matrixant/f1c200s_core/README.md

#f1c200s_core

> 已打板点灯验证，没有测试过稳定性，谨慎应用。

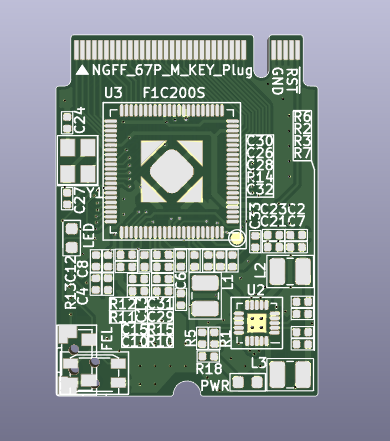
[picture p1: PCB1.png]
PCB1

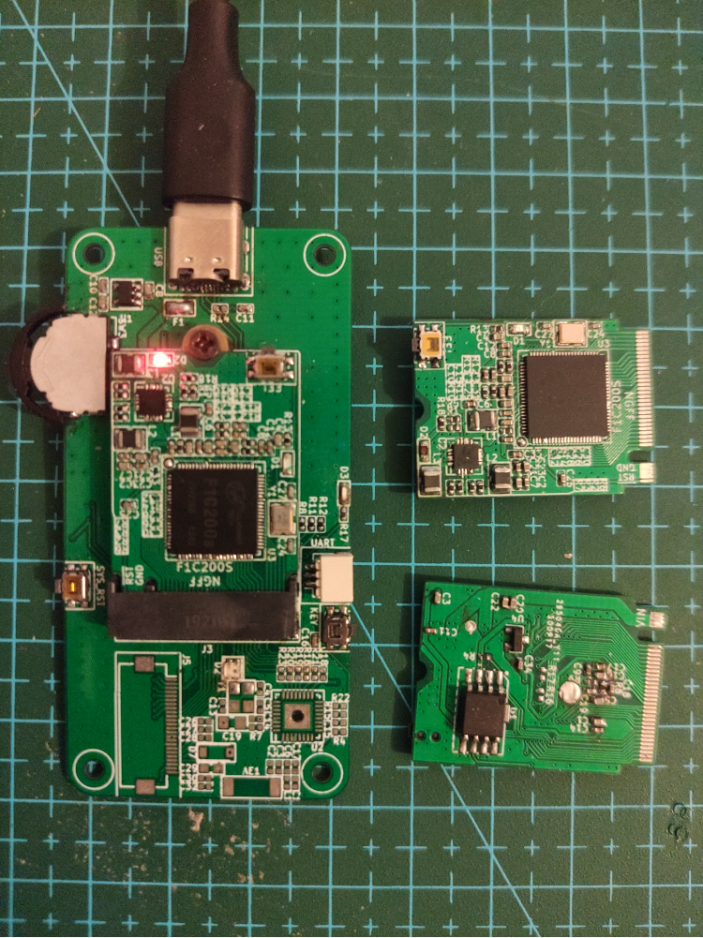
[picture p2: PCB2.png]
PCB2
