matrixant/f1c200s_core/f1c200s_core_v1.0.pdf

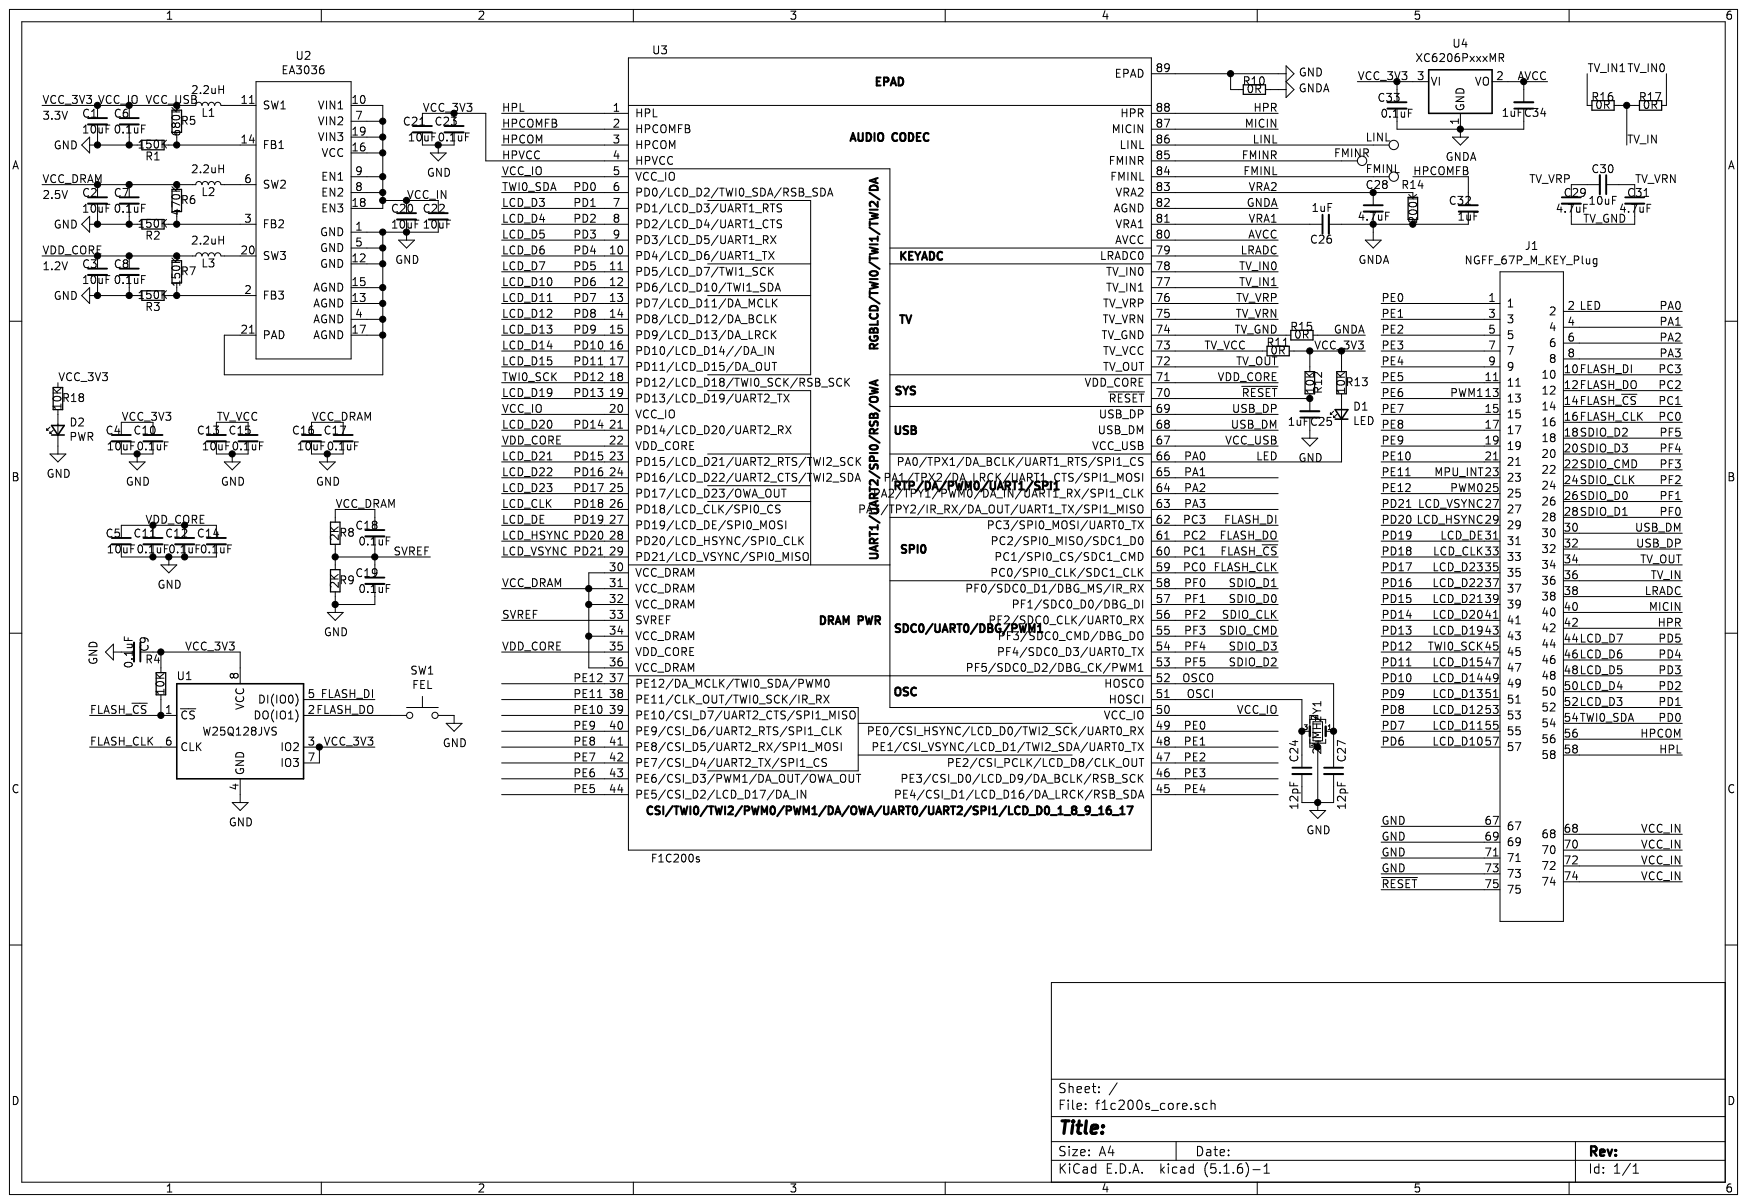
[picture p3: page 1]
