matrixant/f1c200s_core/f1c200s_core.kicad_pcb

## KiCad design f1c200s_core.kicad_pcb (2021-12-30)

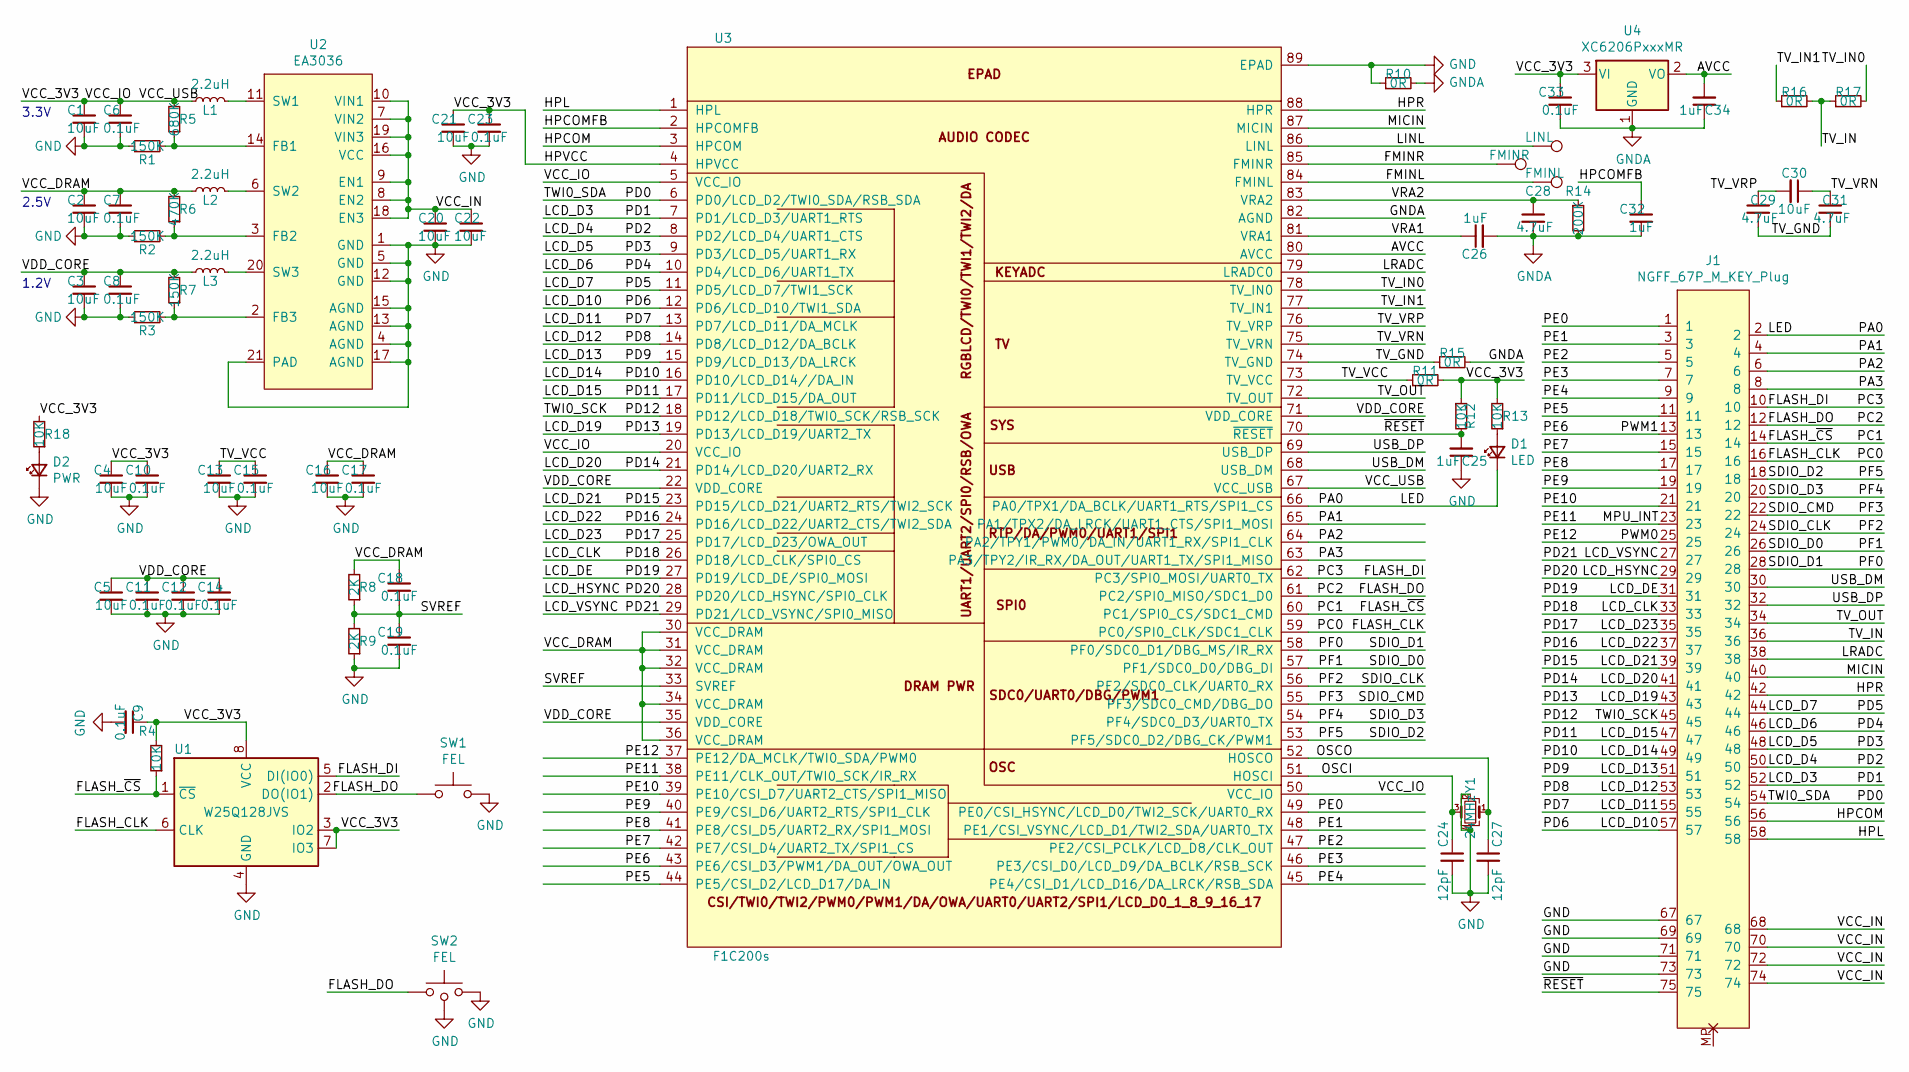
[picture p4: schematic f1c200s_core.kicad_sch]

Parts:
C1, C2, C3, C4, C5, C13, C16, C20, C21, C22, C30: 10uF; C_0402_1005Metric
C6, C7, C8, C9, C10, C11, C12, C14, C15, C17, C18, C19, C23, C33: 0.1uF; C_0402_1005Metric
C24, C27: 12pF; C_0402_1005Metric
C25, C26, C32, C34: 1uF; C_0402_1005Metric
C28, C29, C31: 4.7uF; C_0402_1005Metric
D1: LED; LED_0603_1608Metric
D2: PWR; LED_0603_1608Metric
J1: NGFF_67P_M_KEY_Plug; NGFF_2230_67P_P0.5_M_KEY_Plug
L1, L2, L3: 2.2uH; L_1008_2520Metric
R1, R2, R3, R7: 150K; R_0402_1005Metric
R4, R12, R13, R18: 10K; R_0402_1005Metric
R5: 680K; R_0402_1005Metric
R6: 470K; R_0402_1005Metric
R8, R9: 2K; R_0402_1005Metric
R10, R11, R15, R16, R17: 0R; R_0402_1005Metric
R14: 200K; R_0402_1005Metric
SW1: FEL; Key_Push_3.5x5x1.5_Side_4P
SW2: FEL; Key_Push_2x4x3.5_Side_4P
TP1: FMINR; TestPoint_Pad_D1.0mm
TP2: LINL; TestPoint_Pad_D1.0mm
TP3: FMINL; TestPoint_Pad_D1.0mm
U1: W25Q128JVS; WSON-8_8x6mm
U2: EA3036; QFN-20_EP_3x3_Pitch0.4mm_ThermalVias
U3: F1C200s; QFN-88_EP_10x10_Pitch0.4mm_Handsoldering
U4: XC6206PxxxMR; SOT-23
Y1: 24MHz; Crystal_SMD_3225-4Pin_3.2x2.5mm

Connections:
/AVCC: C34.2, U3.80 (AVCC), U4.2 (VO)
/FLASH_CLK: J1.16, U1.6 (CLK), U3.59 (PC0/SPI0_CLK/SDC1_CLK)
/FLASH_DI: J1.10, U1.5 (DI(IO0)), U3.62 (PC3/SPI0_MOSI/UART0_TX)
/FLASH_DO: J1.12, SW1.2, SW2.2, U1.2 (DO(IO1)), U3.61 (PC2/SPI0_MISO/SDC1_D0)
/FLASH_~CS: J1.14, R4.1, U1.1 (~CS), U3.60 (PC1/SPI0_CS/SDC1_CMD)
/FMINL: TP3.1, U3.84 (FMINL)
/FMINR: TP1.1, U3.85 (FMINR)
/HPCOM: J1.56, U3.3 (HPCOM)
/HPCOMFB: C32.1, U3.2 (HPCOMFB)
/HPL: J1.58, U3.1 (HPL)
/HPR: J1.42, U3.88 (HPR)
/HPVCC: C1.1, C4.1, C6.1, C9.1, C10.1, C21.1, C23.1, C33.1, L1.1, R4.2, R5.2, R11.2, R12.1, R13.2, R18.2, U1.3 (IO2), U1.7 (IO3), U1.8 (VCC), U3.4 (HPVCC), U3.5 (VCC_IO), U3.20 (VCC_IO), U3.50 (VCC_IO), U3.67 (VCC_USB), U4.3 (VI)
/LCD_CLK: J1.33, U3.26 (PD18/LCD_CLK/SPI0_CS)
/LCD_D3: J1.52, U3.7 (PD1/LCD_D3/UART1_RTS)
/LCD_D4: J1.50, U3.8 (PD2/LCD_D4/UART1_CTS)
/LCD_D5: J1.48, U3.9 (PD3/LCD_D5/UART1_RX)
/LCD_D6: J1.46, U3.10 (PD4/LCD_D6/UART1_TX)
/LCD_D7: J1.44, U3.11 (PD5/LCD_D7/TWI1_SCK)
/LCD_D10: J1.57, U3.12 (PD6/LCD_D10/TWI1_SDA)
/LCD_D11: J1.55, U3.13 (PD7/LCD_D11/DA_MCLK)
/LCD_D12: J1.53, U3.14 (PD8/LCD_D12/DA_BCLK)
/LCD_D13: J1.51, U3.15 (PD9/LCD_D13/DA_LRCK)
/LCD_D14: J1.49, U3.16 (PD10/LCD_D14//DA_IN)
/LCD_D15: J1.47, U3.17 (PD11/LCD_D15/DA_OUT)
/LCD_D19: J1.43, U3.19 (PD13/LCD_D19/UART2_TX)
/LCD_D20: J1.41, U3.21 (PD14/LCD_D20/UART2_RX)
/LCD_D21: J1.39, U3.23 (PD15/LCD_D21/UART2_RTS/TWI2_SCK)
/LCD_D22: J1.37, U3.24 (PD16/LCD_D22/UART2_CTS/TWI2_SDA)
/LCD_D23: J1.35, U3.25 (PD17/LCD_D23/OWA_OUT)
/LCD_DE: J1.31, U3.27 (PD19/LCD_DE/SPI0_MOSI)
/LCD_HSYNC: J1.29, U3.28 (PD20/LCD_HSYNC/SPI0_CLK)
/LCD_VSYNC: J1.27, U3.29 (PD21/LCD_VSYNC/SPI0_MISO)
/LED: D1.1 (K), J1.2, U3.66 (PA0/TPX1/DA_BCLK/UART1_RTS/SPI1_CS)
/LINL: TP2.1, U3.86 (LINL)
/LRADC: J1.38, U3.79 (LRADC0)
/MICIN: J1.40, U3.87 (MICIN)
/MPU_INT: J1.23, U3.38 (PE11/CLK_OUT/TWI0_SCK/IR_RX)
/OSCI: C24.1, U3.51 (HOSCI), Y1.3
/OSCO: C27.1, U3.52 (HOSCO), Y1.1
/PA1: J1.4, U3.65 (PA1/TPX2/DA_LRCK/UART1_CTS/SPI1_MOSI)
/PA2: J1.6, U3.64 (PA2/TPY1/PWM0/DA_IN/UART1_RX/SPI1_CLK)
/PA3: J1.8, U3.63 (PA3/TPY2/IR_RX/DA_OUT/UART1_TX/SPI1_MISO)
/PD0: J1.54, U3.6 (PD0/LCD_D2/TWI0_SDA/RSB_SDA)
/PD12: J1.45, U3.18 (PD12/LCD_D18/TWI0_SCK/RSB_SCK)
/PE0: J1.1, U3.49 (PE0/CSI_HSYNC/LCD_D0/TWI2_SCK/UART0_RX)
/PE1: J1.3, U3.48 (PE1/CSI_VSYNC/LCD_D1/TWI2_SDA/UART0_TX)
/PE2: J1.5, U3.47 (PE2/CSI_PCLK/LCD_D8/CLK_OUT)
/PE3: J1.7, U3.46 (PE3/CSI_D0/LCD_D9/DA_BCLK/RSB_SCK)
/PE4: J1.9, U3.45 (PE4/CSI_D1/LCD_D16/DA_LRCK/RSB_SDA)
/PE5: J1.11, U3.44 (PE5/CSI_D2/LCD_D17/DA_IN)
/PE6: J1.13, U3.43 (PE6/CSI_D3/PWM1/DA_OUT/OWA_OUT)
/PE7: J1.15, U3.42 (PE7/CSI_D4/UART2_TX/SPI1_CS)
/PE8: J1.17, U3.41 (PE8/CSI_D5/UART2_RX/SPI1_MOSI)
/PE9: J1.19, U3.40 (PE9/CSI_D6/UART2_RTS/SPI1_CLK)
/PE10: J1.21, U3.39 (PE10/CSI_D7/UART2_CTS/SPI1_MISO)
/PE12: J1.25, U3.37 (PE12/DA_MCLK/TWI0_SDA/PWM0)
/PF0: J1.28, U3.58 (PF0/SDC0_D1/DBG_MS/IR_RX)
/PF1: J1.26, U3.57 (PF1/SDC0_D0/DBG_DI)
/PF2: J1.24, U3.56 (PF2/SDC0_CLK/UART0_RX)
/PF3: J1.22, U3.55 (PF3/SDC0_CMD/DBG_DO)
/PF4: J1.20, U3.54 (PF4/SDC0_D3/UART0_TX)
/PF5: J1.18, U3.53 (PF5/SDC0_D2/DBG_CK/PWM1)
/SVREF: C18.2, C19.1, R8.1, R9.2, U3.33 (SVREF)
/TV_GND: C29.2, C31.2, R15.1, U3.74 (TV_GND)
/TV_IN: J1.36, R16.2, R17.1
/TV_IN0: R17.2, U3.78 (TV_IN0)
/TV_IN1: R16.1, U3.77 (TV_IN1)
/TV_OUT: J1.34, U3.72 (TV_OUT)
/TV_VCC: C13.1, C15.1, R11.1, U3.73 (TV_VCC)
/TV_VRN: C30.1, C31.1, U3.75 (TV_VRN)
/TV_VRP: C29.1, C30.2, U3.76 (TV_VRP)
/USB_DM: J1.30, U3.68 (USB_DM)
/USB_DP: J1.32, U3.69 (USB_DP)
/VCC_DRAM: C2.1, C7.1, C16.1, C17.1, C18.1, L2.1, R6.2, R8.2, U3.30 (VCC_DRAM), U3.31 (VCC_DRAM), U3.32 (VCC_DRAM), U3.34 (VCC_DRAM), U3.36 (VCC_DRAM)
/VCC_IN: C20.1, C22.1, J1.68, J1.70, J1.72, J1.74, U2.7 (VIN2), U2.8 (EN2), U2.9 (EN1), U2.10 (VIN1), U2.16 (VCC), U2.18 (EN3), U2.19 (VIN3)
/VDD_CORE: C3.1, C5.1, C8.1, C11.1, C12.1, C14.1, L3.1, R7.2, U3.22 (VDD_CORE), U3.35 (VDD_CORE), U3.71 (VDD_CORE)
/VRA1: C26.1, U3.81 (VRA1)
/VRA2: C28.1, R14.1, U3.83 (VRA2)
/~RESET: C25.2, J1.75, R12.2, U3.70 (~RESET)
GND: C1.2, C2.2, C3.2, C4.2, C5.2, C6.2, C7.2, C8.2, C9.2, C10.2, C11.2, C12.2, C13.2, C14.2, C15.2, C16.2, C17.2, C19.2, C20.2, C21.2, C22.2, C23.2, C24.2, C25.1, C27.2, D2.1 (K), J1.67, J1.69, J1.71, J1.73, R1.1, R2.1, R3.1, R9.1, R10.1, SW1.1, SW2.1, SW2.3 (GND), U1.4 (GND), U2.1 (GND), U2.4 (AGND), U2.5 (GND), U2.12 (GND), U2.13 (AGND), U2.15 (AGND), U2.17 (AGND), U2.21 (PAD), U3.89 (EPAD), Y1.2, Y1.4
GNDA: C26.2, C28.2, C32.2, C33.2, C34.1, R10.2, R14.2, R15.2, U3.82 (AGND), U4.1 (GND)
unnamed: D1.2 (A), R13.1
unnamed: D2.2 (A), R18.1
unnamed: L1.2, U2.11 (SW1)
unnamed: L2.2, U2.6 (SW2)
unnamed: L3.2, U2.20 (SW3)
unnamed: R1.2, R5.1, U2.14 (FB1)
unnamed: R2.2, R6.1, U2.3 (FB2)
unnamed: R3.2, R7.1, U2.2 (FB3)

Notes on the sheet:
2.5V
3.3V
1.2V

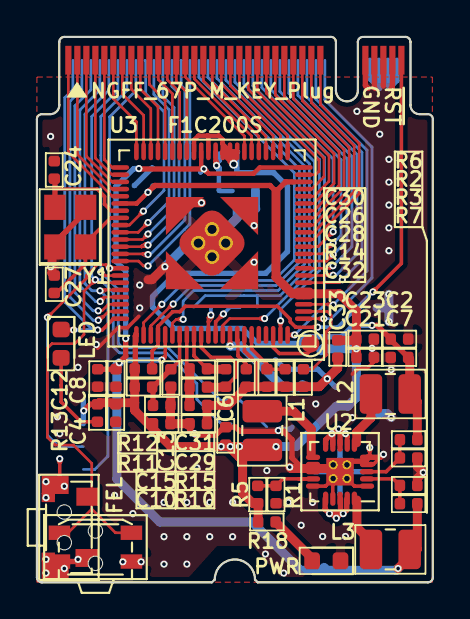
[picture p5: board f1c200s_core.kicad_pcb from above]

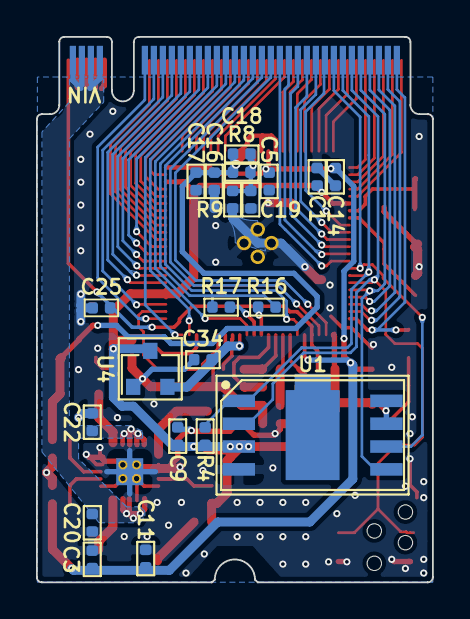
[picture p6: board f1c200s_core.kicad_pcb from below]

Board: 2 copper layers, 22.0 x 30.3 mm, 66 parts (21 on the bottom side), 87 nets.
