matrixant/f1c200s_core/(commit log)

2021-12-30 add pcb picture
2021-12-30 Save as KiCad 6 project
    [f1c200s_core.kicad_pcb, f1c200s_core.kicad_sch]
